thinkoco/mi-lcd/figure/clocked_video_out_timing.png

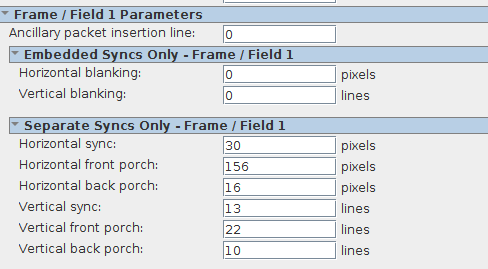
figure/clocked_video_out_timing.png
