thinkoco/mi-lcd/(list of files, drawings)

Other design files:
Schematic_PCB/Altium_Designer/5.0inch_IPS_for_TerasicDEs.PrjPCB
Schematic_PCB/Altium_Designer/5.0inch_IPS_for_TerasicDEs.SchDoc
