thinkoco/mi-lcd/Demonstration/DE10_NANO_MIL_PAINTER/software/tftlcd_ili9806g/main.c

// --------------------------------------------------------------------
// Copyright (c) 2011 by Terasic Technologies Inc. 
// --------------------------------------------------------------------
//
// Permission:
//
//   Terasic grants permission to use and modify this code for use
//   in synthesis for all Terasic Development Boards and Altera Development 
//   Kits made by Terasic.  Other use of this code, including the selling 
//   ,duplication, or modification of any portion is strictly prohibited.
//
// Disclaimer:
//
//   This VHDL/Verilog or C/C++ source code is intended as a design reference
//   which illustrates how these types of functions can be implemented.
//   It is the user's responsibility to verify their design for
//   consistency and functionality through the use of formal
//   verification methods.  Terasic provides no warranty regarding the use 
//   or functionality of this code.
//
// --------------------------------------------------------------------
//           
//                     Terasic Technologies Inc
//                     356 Fu-Shin E. Rd Sec. 1. JhuBei City,
//                     HsinChu County, Taiwan
//                     302
//
//                     web: http://www.terasic.com/
//                     email: support@terasic.com
//
// --------------------------------------------------------------------


#include "terasic_includes.h"
//#include "i2c.h"
#include "lcd.h"
#include "I2C_core.h"
#include "multi_touch2.h"
#include "gui.h"
#include "system.h"


int main()
{
	Lcd_Initialize();
    // touch
    MTC2_INFO *pTouch;
    const bool bVPG = ((IORD(KEY_BASE, 0x00) & 0x01) == 0x00)?TRUE:FALSE;
    IOWR(LED_BASE, 0x00, 0xFF); // high-active
  //  if (LCD_Open()){
   //     LCD_TextOut(bVPG?"Multi-Touch\nPattern\n" : "Multi-Touch\nPainter\n");
   // }
    printf("Terasic Painter Demo\r\n");

    oc_i2c_init(I2C_OPENCORES_0_BASE);

    usleep(1000);

    pTouch=MTC2_Init(I2C_OPENCORES_0_BASE,LCD_TOUCH_INT_BASE,LCD_TOUCH_INT_IRQ);
    if (!pTouch){
        printf("Failed to init multi-touch\r\n");
    }else{
        printf("Init touch successfully\r\n");

    }
   if (bVPG)
       GUI_VPG(pTouch); // enter vpg mode when users press KEY0
       GUI(pTouch);
  return 0;
}
