thinkoco/mi-lcd/Demonstration/DE10_NANO_MIL_PAINTER/software/nios2_mcu_bsp/system.h

/*
 * system.h - SOPC Builder system and BSP software package information
 *
 * Machine generated for CPU 'cpu' in SOPC Builder design 'MIL_PAINTER'
 * SOPC Builder design path: ../../MIL_PAINTER.sopcinfo
 *
 * Generated: Sun Oct 11 22:41:57 CST 2020
 */

/*
 * DO NOT MODIFY THIS FILE
 *
 * Changing this file will have subtle consequences
 * which will almost certainly lead to a nonfunctioning
 * system. If you do modify this file, be aware that your
 * changes will be overwritten and lost when this file
 * is generated again.
 *
 * DO NOT MODIFY THIS FILE
 */

/*
 * License Agreement
 *
 * Copyright (c) 2008
 * Altera Corporation, San Jose, California, USA.
 * All rights reserved.
 *
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
 * This agreement shall be governed in all respects by the laws of the State
 * of California and by the laws of the United States of America.
 */

#ifndef __SYSTEM_H_
#define __SYSTEM_H_

/* Include definitions from linker script generator */
#include "linker.h"


/*
 * CPU configuration
 *
 */

#define ALT_CPU_ARCHITECTURE "altera_nios2_gen2"
#define ALT_CPU_BIG_ENDIAN 0
#define ALT_CPU_BREAK_ADDR 0x05001820
#define ALT_CPU_CPU_ARCH_NIOS2_R1
#define ALT_CPU_CPU_FREQ 100000000u
#define ALT_CPU_CPU_ID_SIZE 1
#define ALT_CPU_CPU_ID_VALUE 0x00000000
#define ALT_CPU_CPU_IMPLEMENTATION "fast"
#define ALT_CPU_DATA_ADDR_WIDTH 0x1b
#define ALT_CPU_DCACHE_BYPASS_MASK 0x80000000
#define ALT_CPU_DCACHE_LINE_SIZE 32
#define ALT_CPU_DCACHE_LINE_SIZE_LOG2 5
#define ALT_CPU_DCACHE_SIZE 2048
#define ALT_CPU_EXCEPTION_ADDR 0x02000020
#define ALT_CPU_FLASH_ACCELERATOR_LINES 0
#define ALT_CPU_FLASH_ACCELERATOR_LINE_SIZE 0
#define ALT_CPU_FLUSHDA_SUPPORTED
#define ALT_CPU_FREQ 100000000
#define ALT_CPU_HARDWARE_DIVIDE_PRESENT 0
#define ALT_CPU_HARDWARE_MULTIPLY_PRESENT 1
#define ALT_CPU_HARDWARE_MULX_PRESENT 0
#define ALT_CPU_HAS_DEBUG_CORE 1
#define ALT_CPU_HAS_DEBUG_STUB
#define ALT_CPU_HAS_EXTRA_EXCEPTION_INFO
#define ALT_CPU_HAS_ILLEGAL_INSTRUCTION_EXCEPTION
#define ALT_CPU_HAS_JMPI_INSTRUCTION
#define ALT_CPU_ICACHE_LINE_SIZE 32
#define ALT_CPU_ICACHE_LINE_SIZE_LOG2 5
#define ALT_CPU_ICACHE_SIZE 4096
#define ALT_CPU_INITDA_SUPPORTED
#define ALT_CPU_INST_ADDR_WIDTH 0x1b
#define ALT_CPU_NAME "cpu"
#define ALT_CPU_NUM_OF_SHADOW_REG_SETS 0
#define ALT_CPU_OCI_VERSION 1
#define ALT_CPU_RESET_ADDR 0x02000000


/*
 * CPU configuration (with legacy prefix - don't use these anymore)
 *
 */

#define NIOS2_BIG_ENDIAN 0
#define NIOS2_BREAK_ADDR 0x05001820
#define NIOS2_CPU_ARCH_NIOS2_R1
#define NIOS2_CPU_FREQ 100000000u
#define NIOS2_CPU_ID_SIZE 1
#define NIOS2_CPU_ID_VALUE 0x00000000
#define NIOS2_CPU_IMPLEMENTATION "fast"
#define NIOS2_DATA_ADDR_WIDTH 0x1b
#define NIOS2_DCACHE_BYPASS_MASK 0x80000000
#define NIOS2_DCACHE_LINE_SIZE 32
#define NIOS2_DCACHE_LINE_SIZE_LOG2 5
#define NIOS2_DCACHE_SIZE 2048
#define NIOS2_EXCEPTION_ADDR 0x02000020
#define NIOS2_FLASH_ACCELERATOR_LINES 0
#define NIOS2_FLASH_ACCELERATOR_LINE_SIZE 0
#define NIOS2_FLUSHDA_SUPPORTED
#define NIOS2_HARDWARE_DIVIDE_PRESENT 0
#define NIOS2_HARDWARE_MULTIPLY_PRESENT 1
#define NIOS2_HARDWARE_MULX_PRESENT 0
#define NIOS2_HAS_DEBUG_CORE 1
#define NIOS2_HAS_DEBUG_STUB
#define NIOS2_HAS_EXTRA_EXCEPTION_INFO
#define NIOS2_HAS_ILLEGAL_INSTRUCTION_EXCEPTION
#define NIOS2_HAS_JMPI_INSTRUCTION
#define NIOS2_ICACHE_LINE_SIZE 32
#define NIOS2_ICACHE_LINE_SIZE_LOG2 5
#define NIOS2_ICACHE_SIZE 4096
#define NIOS2_INITDA_SUPPORTED
#define NIOS2_INST_ADDR_WIDTH 0x1b
#define NIOS2_NUM_OF_SHADOW_REG_SETS 0
#define NIOS2_OCI_VERSION 1
#define NIOS2_RESET_ADDR 0x02000000


/*
 * Define for each module class mastered by the CPU
 *
 */

#define __ALTERA_AVALON_EPCS_FLASH_CONTROLLER
#define __ALTERA_AVALON_JTAG_UART
#define __ALTERA_AVALON_PIO
#define __ALTERA_AVALON_SPI
#define __ALTERA_AVALON_SYSID_QSYS
#define __ALTERA_AVALON_TIMER
#define __ALTERA_NIOS2_GEN2
#define __ALT_VIP_VFR
#define __I2C_OPENCORES
#define __I8080_CONTROLLER
#define __MISTER_SDRAM32M_CONTROLLER


/*
 * System configuration
 *
 */

#define ALT_DEVICE_FAMILY "Cyclone V"
#define ALT_ENHANCED_INTERRUPT_API_PRESENT
#define ALT_IRQ_BASE NULL
#define ALT_LOG_PORT "/dev/null"
#define ALT_LOG_PORT_BASE 0x0
#define ALT_LOG_PORT_DEV null
#define ALT_LOG_PORT_TYPE ""
#define ALT_NUM_EXTERNAL_INTERRUPT_CONTROLLERS 0
#define ALT_NUM_INTERNAL_INTERRUPT_CONTROLLERS 1
#define ALT_NUM_INTERRUPT_CONTROLLERS 1
#define ALT_STDERR "/dev/jtag_uart"
#define ALT_STDERR_BASE 0x50020d8
#define ALT_STDERR_DEV jtag_uart
#define ALT_STDERR_IS_JTAG_UART
#define ALT_STDERR_PRESENT
#define ALT_STDERR_TYPE "altera_avalon_jtag_uart"
#define ALT_STDIN "/dev/jtag_uart"
#define ALT_STDIN_BASE 0x50020d8
#define ALT_STDIN_DEV jtag_uart
#define ALT_STDIN_IS_JTAG_UART
#define ALT_STDIN_PRESENT
#define ALT_STDIN_TYPE "altera_avalon_jtag_uart"
#define ALT_STDOUT "/dev/jtag_uart"
#define ALT_STDOUT_BASE 0x50020d8
#define ALT_STDOUT_DEV jtag_uart
#define ALT_STDOUT_IS_JTAG_UART
#define ALT_STDOUT_PRESENT
#define ALT_STDOUT_TYPE "altera_avalon_jtag_uart"
#define ALT_SYSTEM_NAME "MIL_PAINTER"


/*
 * alt_vip_vfr_0 configuration
 *
 */

#define ALT_MODULE_CLASS_alt_vip_vfr_0 alt_vip_vfr
#define ALT_VIP_VFR_0_BASE 0x5002000
#define ALT_VIP_VFR_0_IRQ 3
#define ALT_VIP_VFR_0_IRQ_INTERRUPT_CONTROLLER_ID 0
#define ALT_VIP_VFR_0_NAME "/dev/alt_vip_vfr_0"
#define ALT_VIP_VFR_0_SPAN 128
#define ALT_VIP_VFR_0_TYPE "alt_vip_vfr"


/*
 * epcs_flash_controller_0 configuration
 *
 */

#define ALT_MODULE_CLASS_epcs_flash_controller_0 altera_avalon_epcs_flash_controller
#define EPCS_FLASH_CONTROLLER_0_BASE 0x5001000
#define EPCS_FLASH_CONTROLLER_0_IRQ 4
#define EPCS_FLASH_CONTROLLER_0_IRQ_INTERRUPT_CONTROLLER_ID 0
#define EPCS_FLASH_CONTROLLER_0_NAME "/dev/epcs_flash_controller_0"
#define EPCS_FLASH_CONTROLLER_0_REGISTER_OFFSET 1024
#define EPCS_FLASH_CONTROLLER_0_SPAN 2048
#define EPCS_FLASH_CONTROLLER_0_TYPE "altera_avalon_epcs_flash_controller"


/*
 * hal configuration
 *
 */

#define ALT_INCLUDE_INSTRUCTION_RELATED_EXCEPTION_API
#define ALT_MAX_FD 32
#define ALT_SYS_CLK TIMER
#define ALT_TIMESTAMP_CLK none


/*
 * i2c_opencores_0 configuration
 *
 */

#define ALT_MODULE_CLASS_i2c_opencores_0 i2c_opencores
#define I2C_OPENCORES_0_BASE 0x50020a0
#define I2C_OPENCORES_0_IRQ 6
#define I2C_OPENCORES_0_IRQ_INTERRUPT_CONTROLLER_ID 0
#define I2C_OPENCORES_0_NAME "/dev/i2c_opencores_0"
#define I2C_OPENCORES_0_SPAN 32
#define I2C_OPENCORES_0_TYPE "i2c_opencores"


/*
 * jtag_uart configuration
 *
 */

#define ALT_MODULE_CLASS_jtag_uart altera_avalon_jtag_uart
#define JTAG_UART_BASE 0x50020d8
#define JTAG_UART_IRQ 0
#define JTAG_UART_IRQ_INTERRUPT_CONTROLLER_ID 0
#define JTAG_UART_NAME "/dev/jtag_uart"
#define JTAG_UART_READ_DEPTH 64
#define JTAG_UART_READ_THRESHOLD 8
#define JTAG_UART_SPAN 8
#define JTAG_UART_TYPE "altera_avalon_jtag_uart"
#define JTAG_UART_WRITE_DEPTH 64
#define JTAG_UART_WRITE_THRESHOLD 8


/*
 * key configuration
 *
 */

#define ALT_MODULE_CLASS_key altera_avalon_pio
#define KEY_BASE 0x4000020
#define KEY_BIT_CLEARING_EDGE_REGISTER 0
#define KEY_BIT_MODIFYING_OUTPUT_REGISTER 0
#define KEY_CAPTURE 1
#define KEY_DATA_WIDTH 4
#define KEY_DO_TEST_BENCH_WIRING 0
#define KEY_DRIVEN_SIM_VALUE 0
#define KEY_EDGE_TYPE "FALLING"
#define KEY_FREQ 20000000
#define KEY_HAS_IN 1
#define KEY_HAS_OUT 0
#define KEY_HAS_TRI 0
#define KEY_IRQ 2
#define KEY_IRQ_INTERRUPT_CONTROLLER_ID 0
#define KEY_IRQ_TYPE "EDGE"
#define KEY_NAME "/dev/key"
#define KEY_RESET_VALUE 0
#define KEY_SPAN 16
#define KEY_TYPE "altera_avalon_pio"


/*
 * lcd_i8080 configuration
 *
 */

#define ALT_MODULE_CLASS_lcd_i8080 I8080_Controller
#define LCD_I8080_BASE 0x50020d0
#define LCD_I8080_IRQ -1
#define LCD_I8080_IRQ_INTERRUPT_CONTROLLER_ID -1
#define LCD_I8080_NAME "/dev/lcd_i8080"
#define LCD_I8080_SPAN 8
#define LCD_I8080_TYPE "I8080_Controller"


/*
 * lcd_spi configuration
 *
 */

#define ALT_MODULE_CLASS_lcd_spi altera_avalon_spi
#define LCD_SPI_BASE 0x5002080
#define LCD_SPI_CLOCKMULT 1
#define LCD_SPI_CLOCKPHASE 0
#define LCD_SPI_CLOCKPOLARITY 0
#define LCD_SPI_CLOCKUNITS "Hz"
#define LCD_SPI_DATABITS 9
#define LCD_SPI_DATAWIDTH 16
#define LCD_SPI_DELAYMULT "1.0E-9"
#define LCD_SPI_DELAYUNITS "ns"
#define LCD_SPI_EXTRADELAY 0
#define LCD_SPI_INSERT_SYNC 0
#define LCD_SPI_IRQ 7
#define LCD_SPI_IRQ_INTERRUPT_CONTROLLER_ID 0
#define LCD_SPI_ISMASTER 1
#define LCD_SPI_LSBFIRST 0
#define LCD_SPI_NAME "/dev/lcd_spi"
#define LCD_SPI_NUMSLAVES 1
#define LCD_SPI_PREFIX "spi_"
#define LCD_SPI_SPAN 32
#define LCD_SPI_SYNC_REG_DEPTH 2
#define LCD_SPI_TARGETCLOCK 1000000u
#define LCD_SPI_TARGETSSDELAY "0.0"
#define LCD_SPI_TYPE "altera_avalon_spi"


/*
 * lcd_touch_int configuration
 *
 */

#define ALT_MODULE_CLASS_lcd_touch_int altera_avalon_pio
#define LCD_TOUCH_INT_BASE 0x50020c0
#define LCD_TOUCH_INT_BIT_CLEARING_EDGE_REGISTER 0
#define LCD_TOUCH_INT_BIT_MODIFYING_OUTPUT_REGISTER 0
#define LCD_TOUCH_INT_CAPTURE 1
#define LCD_TOUCH_INT_DATA_WIDTH 1
#define LCD_TOUCH_INT_DO_TEST_BENCH_WIRING 0
#define LCD_TOUCH_INT_DRIVEN_SIM_VALUE 0
#define LCD_TOUCH_INT_EDGE_TYPE "FALLING"
#define LCD_TOUCH_INT_FREQ 50000000
#define LCD_TOUCH_INT_HAS_IN 1
#define LCD_TOUCH_INT_HAS_OUT 0
#define LCD_TOUCH_INT_HAS_TRI 0
#define LCD_TOUCH_INT_IRQ 5
#define LCD_TOUCH_INT_IRQ_INTERRUPT_CONTROLLER_ID 0
#define LCD_TOUCH_INT_IRQ_TYPE "EDGE"
#define LCD_TOUCH_INT_NAME "/dev/lcd_touch_int"
#define LCD_TOUCH_INT_RESET_VALUE 0
#define LCD_TOUCH_INT_SPAN 16
#define LCD_TOUCH_INT_TYPE "altera_avalon_pio"


/*
 * led configuration
 *
 */

#define ALT_MODULE_CLASS_led altera_avalon_pio
#define LED_BASE 0x4000040
#define LED_BIT_CLEARING_EDGE_REGISTER 0
#define LED_BIT_MODIFYING_OUTPUT_REGISTER 0
#define LED_CAPTURE 0
#define LED_DATA_WIDTH 10
#define LED_DO_TEST_BENCH_WIRING 0
#define LED_DRIVEN_SIM_VALUE 0
#define LED_EDGE_TYPE "NONE"
#define LED_FREQ 20000000
#define LED_HAS_IN 0
#define LED_HAS_OUT 1
#define LED_HAS_TRI 0
#define LED_IRQ -1
#define LED_IRQ_INTERRUPT_CONTROLLER_ID -1
#define LED_IRQ_TYPE "NONE"
#define LED_NAME "/dev/led"
#define LED_RESET_VALUE 0
#define LED_SPAN 16
#define LED_TYPE "altera_avalon_pio"


/*
 * mister_sdram32m configuration
 *
 */

#define ALT_MODULE_CLASS_mister_sdram32m mister_sdram32m_controller
#define MISTER_SDRAM32M_BASE 0x2000000
#define MISTER_SDRAM32M_IRQ -1
#define MISTER_SDRAM32M_IRQ_INTERRUPT_CONTROLLER_ID -1
#define MISTER_SDRAM32M_NAME "/dev/mister_sdram32m"
#define MISTER_SDRAM32M_SPAN 33554432
#define MISTER_SDRAM32M_TYPE "mister_sdram32m_controller"


/*
 * sw configuration
 *
 */

#define ALT_MODULE_CLASS_sw altera_avalon_pio
#define SW_BASE 0x4000030
#define SW_BIT_CLEARING_EDGE_REGISTER 0
#define SW_BIT_MODIFYING_OUTPUT_REGISTER 0
#define SW_CAPTURE 0
#define SW_DATA_WIDTH 10
#define SW_DO_TEST_BENCH_WIRING 0
#define SW_DRIVEN_SIM_VALUE 0
#define SW_EDGE_TYPE "NONE"
#define SW_FREQ 20000000
#define SW_HAS_IN 1
#define SW_HAS_OUT 0
#define SW_HAS_TRI 0
#define SW_IRQ -1
#define SW_IRQ_INTERRUPT_CONTROLLER_ID -1
#define SW_IRQ_TYPE "NONE"
#define SW_NAME "/dev/sw"
#define SW_RESET_VALUE 0
#define SW_SPAN 16
#define SW_TYPE "altera_avalon_pio"


/*
 * sysid configuration
 *
 */

#define ALT_MODULE_CLASS_sysid altera_avalon_sysid_qsys
#define SYSID_BASE 0x4000050
#define SYSID_ID 0
#define SYSID_IRQ -1
#define SYSID_IRQ_INTERRUPT_CONTROLLER_ID -1
#define SYSID_NAME "/dev/sysid"
#define SYSID_SPAN 8
#define SYSID_TIMESTAMP 1602426544
#define SYSID_TYPE "altera_avalon_sysid_qsys"


/*
 * timer configuration
 *
 */

#define ALT_MODULE_CLASS_timer altera_avalon_timer
#define TIMER_ALWAYS_RUN 0
#define TIMER_BASE 0x4000000
#define TIMER_COUNTER_SIZE 32
#define TIMER_FIXED_PERIOD 0
#define TIMER_FREQ 20000000
#define TIMER_IRQ 1
#define TIMER_IRQ_INTERRUPT_CONTROLLER_ID 0
#define TIMER_LOAD_VALUE 19999
#define TIMER_MULT 0.001
#define TIMER_NAME "/dev/timer"
#define TIMER_PERIOD 1
#define TIMER_PERIOD_UNITS "ms"
#define TIMER_RESET_OUTPUT 0
#define TIMER_SNAPSHOT 1
#define TIMER_SPAN 32
#define TIMER_TICKS_PER_SEC 1000
#define TIMER_TIMEOUT_PULSE_OUTPUT 0
#define TIMER_TYPE "altera_avalon_timer"

#endif /* __SYSTEM_H_ */
