thinkoco/mi-lcd/Demonstration/DE1_SOC_MIL_PAINTER/DE1_SOC_MIL_PAINTER.v

//`define ENABLE_HPS
//`define ENABLE_USB

module DE1_SOC_MIL_PAINTER(

      ///////// ADC /////////
      inout              ADC_CS_N,
      output             ADC_DIN,
      input              ADC_DOUT,
      output             ADC_SCLK,

      ///////// AUD /////////
      input              AUD_ADCDAT,
      inout              AUD_ADCLRCK,
      inout              AUD_BCLK,
      output             AUD_DACDAT,
      inout              AUD_DACLRCK,
      output             AUD_XCK,

      ///////// CLOCK2 /////////
      input              CLOCK2_50,

      ///////// CLOCK3 /////////
      input              CLOCK3_50,

      ///////// CLOCK4 /////////
      input              CLOCK4_50,

      ///////// CLOCK /////////
      input              CLOCK_50,

      ///////// DRAM /////////
      output      [12:0] DRAM_ADDR,
      output      [1:0]  DRAM_BA,
      output             DRAM_CAS_N,
      output             DRAM_CKE,
      output             DRAM_CLK,
      output             DRAM_CS_N,
      inout       [15:0] DRAM_DQ,
      output             DRAM_LDQM,
      output             DRAM_RAS_N,
      output             DRAM_UDQM,
      output             DRAM_WE_N,

      ///////// FAN /////////
      output             FAN_CTRL,

      ///////// FPGA /////////
      output             FPGA_I2C_SCLK,
      inout              FPGA_I2C_SDAT,

      ///////// GPIO /////////
      inout     [35:0]   GPIO_0,
        
        ///////// HEX0 /////////
      output      [6:0]  HEX0,

      ///////// HEX1 /////////
      output      [6:0]  HEX1,

      ///////// HEX2 /////////
      output      [6:0]  HEX2,

      ///////// HEX3 /////////
      output      [6:0]  HEX3,

      ///////// HEX4 /////////
      output      [6:0]  HEX4,

      ///////// HEX5 /////////
      output      [6:0]  HEX5,

`ifdef ENABLE_HPS
      ///////// HPS /////////
      input              HPS_CONV_USB_N,
      output      [14:0] HPS_DDR3_ADDR,
      output      [2:0]  HPS_DDR3_BA,
      output             HPS_DDR3_CAS_N,
      output             HPS_DDR3_CKE,
      output             HPS_DDR3_CK_N,
      output             HPS_DDR3_CK_P,
      output             HPS_DDR3_CS_N,
      output      [3:0]  HPS_DDR3_DM,
      inout       [31:0] HPS_DDR3_DQ,
      inout       [3:0]  HPS_DDR3_DQS_N,
      inout       [3:0]  HPS_DDR3_DQS_P,
      output             HPS_DDR3_ODT,
      output             HPS_DDR3_RAS_N,
      output             HPS_DDR3_RESET_N,
      input              HPS_DDR3_RZQ,
      output             HPS_DDR3_WE_N,
      output             HPS_ENET_GTX_CLK,
      inout              HPS_ENET_INT_N,
      output             HPS_ENET_MDC,
      inout              HPS_ENET_MDIO,
      input              HPS_ENET_RX_CLK,
      input       [3:0]  HPS_ENET_RX_DATA,
      input              HPS_ENET_RX_DV,
      output      [3:0]  HPS_ENET_TX_DATA,
      output             HPS_ENET_TX_EN,
      inout       [3:0]  HPS_FLASH_DATA,
      output             HPS_FLASH_DCLK,
      output             HPS_FLASH_NCSO,
      inout              HPS_GSENSOR_INT,
      inout              HPS_I2C1_SCLK,
      inout              HPS_I2C1_SDAT,
      inout              HPS_I2C2_SCLK,
      inout              HPS_I2C2_SDAT,
      inout              HPS_I2C_CONTROL,
      inout              HPS_KEY,
      inout              HPS_LED,
      inout              HPS_LTC_GPIO,
      output             HPS_SD_CLK,
      inout              HPS_SD_CMD,
      inout       [3:0]  HPS_SD_DATA,
      output             HPS_SPIM_CLK,
      input              HPS_SPIM_MISO,
      output             HPS_SPIM_MOSI,
      inout              HPS_SPIM_SS,
      input              HPS_UART_RX,
      output             HPS_UART_TX,
      input              HPS_USB_CLKOUT,
      inout       [7:0]  HPS_USB_DATA,
      input              HPS_USB_DIR,
      input              HPS_USB_NXT,
      output             HPS_USB_STP,
`endif /*ENABLE_HPS*/

      ///////// IRDA /////////
      input              IRDA_RXD,
      output             IRDA_TXD,

      ///////// KEY /////////
      input       [3:0]  KEY,

      ///////// LEDR /////////
      output      [9:0]  LEDR,

      ///////// PS2 /////////
      inout              PS2_CLK,
      inout              PS2_CLK2,
      inout              PS2_DAT,
      inout              PS2_DAT2,

      ///////// SW /////////
      input       [9:0]  SW,

      ///////// TD /////////
      input              TD_CLK27,
      input      [7:0]   TD_DATA,
      input              TD_HS,
      output             TD_RESET_N,
      input              TD_VS,

`ifdef ENABLE_USB
      ///////// USB /////////
      input              USB_B2_CLK,
      inout       [7:0]  USB_B2_DATA,
      output             USB_EMPTY,
      output             USB_FULL,
      input              USB_OE_N,
      input              USB_RD_N,
      input              USB_RESET_N,
      inout              USB_SCL,
      inout              USB_SDA,
      input              USB_WR_N,
`endif /*ENABLE_USB*/

      ///////// VGA /////////
      output      [7:0]  VGA_B,
      output             VGA_BLANK_N,
      output             VGA_CLK,
      output      [7:0]  VGA_G,
      output             VGA_HS,
      output      [7:0]  VGA_R,
      output             VGA_SYNC_N,
      output             VGA_VS,

//////////// GPIO, GPIO1 connect to MIL_PAINTER - Multi-Touch LCD Panel //////////     
        input                       LCD_TE,
        inout                       LCD_SDI,
        output                  LCD_WR_SCLK,
        output                  LCD_CS,
        output                  LCD_RS_HSD,
        output                  LCD_RD_VSD,
        inout           [23:0]  LCD_DATA,
        output                  LCD_ENABLE,
        output                  LCD_PCLK,
        output                  TOUCH_SCK,
        inout                       TOUCH_SDA,
        input                       TOUCH_INT
);


//=======================================================
//  REG/WIRE declarations
//=======================================================

wire video_hs;
wire video_vs;
wire video_clk;
wire video_en;


wire [7:0]  video_r;
wire [7:0]  video_g;
wire [7:0]  video_b;
wire clk_30;
wire clk_30_out;

lcd_pll  lcd_pll_inst(
           .refclk(CLOCK2_50),   //  refclk.clk
           .rst(1'b0),      //   reset.reset
           .outclk_0(clk_30), // outclk0.clk
           .outclk_1(clk_30_out), // outclk1.clk
           .locked()    //  locked.export
);

 MIL_PAINTER u0(
        .reset_n(KEY[1]),                                  //               clk_50_clk_in_reset.reset_n
        .clk_50(CLOCK_50),                                   //                     clk_50_clk_in.clk
        .pll_sdram_clk(DRAM_CLK),                             //                         pll_sdram.clk
        
        .zs_addr_from_the_sdram(DRAM_ADDR),                   //                        sdram_wire.addr
        .zs_ba_from_the_sdram(DRAM_BA),                     //                                  .ba
        .zs_cas_n_from_the_sdram(DRAM_CAS_N),                  //                                  .cas_n
        .zs_cke_from_the_sdram(DRAM_CKE),                    //                                  .cke
        .zs_cs_n_from_the_sdram(DRAM_CS_N),                   //                                  .cs_n
        .zs_dq_to_and_from_the_sdram(DRAM_DQ),              //                                  .dq
        .zs_dqm_from_the_sdram({DRAM_UDQM,DRAM_LDQM}),                    //                                  .dqm
        .zs_ras_n_from_the_sdram(DRAM_RAS_N),                  //                                  .ras_n
        .zs_we_n_from_the_sdram(DRAM_WE_N),                   //                                  .we_n
        
        .vid_clk_to_the_alt_vip_itc_0(clk_30),             //       alt_vip_itc_0_clocked_video.vid_clk
        .vid_data_from_the_alt_vip_itc_0({video_r, video_g, video_b}),          //                                  .vid_data
        .underflow_from_the_alt_vip_itc_0(),         //                                  .underflow
        .vid_datavalid_from_the_alt_vip_itc_0(video_en),     //                                  .vid_datavalid
        .vid_v_sync_from_the_alt_vip_itc_0(video_vs),        //                                  .vid_v_sync
        .vid_h_sync_from_the_alt_vip_itc_0(video_hs),        //                                  .vid_h_sync
        .vid_f_from_the_alt_vip_itc_0(),             //                                  .vid_f
        .vid_h_from_the_alt_vip_itc_0(),             //                                  .vid_h
        .vid_v_from_the_alt_vip_itc_0(),             //                                  .vid_v
        
        .out_port_from_the_led(LEDR),                    //           led_external_connection.export
        .in_port_to_the_sw(SW),                        //            sw_external_connection.export
        .in_port_to_the_key(KEY[0]),                       //           key_external_connection.export
        
        .lcd_touch_int_external_connection_export(TOUCH_INT), // lcd_touch_int_external_connection.export
        .i2c_opencores_0_export_scl_pad_io(TOUCH_SCK),        //            i2c_opencores_0_export.scl_pad_io
        .i2c_opencores_0_export_sda_pad_io(TOUCH_SDA),         //                                  .sda_pad_io
        
        .lcd_spi_external_MOSI                    (LCD_SDI),                    //                                  .MOSI
        .lcd_spi_external_SCLK                    (LCD_WR_SCLK),                    //                                  .SCLK
        .lcd_spi_external_SS_n                    (LCD_CS)                     //    
        
    );
    
    

// vga
assign {VGA_R, VGA_G, VGA_B} = {video_r, video_g, video_b};
assign VGA_BLANK_N = 1'b1;
assign VGA_SYNC_N = 1'b0;
assign VGA_HS = ~video_hs;
assign VGA_VS = ~video_vs;
assign VGA_CLK = clk_30_out;


// MTL - display
assign LCD_DATA = {video_r, video_g, video_b};
assign LCD_PCLK = clk_30_out;
assign LCD_RS_HSD = ~video_hs;
assign LCD_RD_VSD = ~video_vs;
assign LCD_ENABLE = video_en;


endmodule
