thinkoco/mi-lcd/Demonstration/DE10_NANO_MIL_PAINTER/software/tftlcd_ili9806g/terasic_lib/I2C_core.c

// --------------------------------------------------------------------
// Copyright (c) 2007 by Terasic Technologies Inc. 
// --------------------------------------------------------------------
//
// Permission:
//
//   Terasic grants permission to use and modify this code for use
//   in synthesis for all Terasic Development Boards and Altera Development 
//   Kits made by Terasic.  Other use of this code, including the selling 
//   ,duplication, or modification of any portion is strictly prohibited.
//
// Disclaimer:
//
//   This VHDL/Verilog or C/C++ source code is intended as a design reference
//   which illustrates how these types of functions can be implemented.
//   It is the user's responsibility to verify their design for
//   consistency and functionality through the use of formal
//   verification methods.  Terasic provides no warranty regarding the use 
//   or functionality of this code.
//
// --------------------------------------------------------------------
//           
//                     Terasic Technologies Inc
//                     356 Fu-Shin E. Rd Sec. 1. JhuBei City,
//                     HsinChu County, Taiwan
//                     302
//
//                     web: http://www.terasic.com/
//                     email: support@terasic.com
//
// --------------------------------------------------------------------
#include "terasic_includes.h"
#include "I2C.h"
#include "io.h"
// Note. Remember to reset device befroe acceess I2C interface
#ifdef DEBUG_I2C
    #define I2C_DEBUG(x)    DEBUG(x)  
#else
    #define I2C_DEBUG(x)
#endif

#define SLEEP_TIME 15  //us
#define TRUE 1
#define FALSE 0

bool Write32_Data(alt_32 base_address, alt_32 offset_address, alt_32 Data){
	bool bPass;
    IOWR(base_address, offset_address,Data);
    bPass=TRUE;
    return bPass;
}



bool  Read32_Data(alt_32 base_address, alt_32 offset_address, alt_32 *pData32){
	bool bPass;
	*pData32 =IORD(base_address ,offset_address  );
	bPass=TRUE;
    return bPass;
}

bool oc_i2c_init(alt_32 i2c_base)
{
	bool bSuccess=TRUE;
	alt_32 read_data;
    // I2c sysclock =50M hz
	// i2c scl max 400k
	//scl =sysclock/(prescale*5)
   IOWR(i2c_base, 0,0x18);//write high prescale
   IOWR(i2c_base, 1,0x00);//write low prescale
   //enable the I2C core, but disable the IRQ
   IOWR( i2c_base, 2,0x80);

    read_data =IORD(i2c_base, 0);
    if( (read_data & 0x00ff) != 0x18)
    {
    	bSuccess = FALSE;
       	read_data =IORD(i2c_base, 1);
		if((read_data & 0x00ff) != 0x00){
			bSuccess = FALSE;
		}
    }
    else if (bSuccess){
    	read_data =IORD(i2c_base, 2);
        if( (read_data & 0x00ff) != 0x80 ){
            bSuccess = FALSE;
        }
    }

   if (bSuccess)
       printf("\nI2C core is enabled! \r\n");
   else
       printf("\nI2C core is not enabled! \r\n");

   return bSuccess;

}

bool  ACK_single_check(alt_32 i2c_base)
{
	bool bSuccess=TRUE;
	alt_32 read_data;

    usleep(SLEEP_TIME);
    read_data =IORD(i2c_base, 4);
    if(read_data & 0x02)
            bSuccess = FALSE;
     if (bSuccess){
            usleep(SLEEP_TIME);
            read_data =IORD(i2c_base, 4);
                if(read_data & 0x80)
                    bSuccess = FALSE;
     }
    return bSuccess;
}


bool  ACK_check(alt_32 i2c_base){
    bool bSuccess = FALSE;
    int i=0;

    while(!bSuccess && i++ < 10){
        bSuccess = ACK_single_check(i2c_base);
    }

    return bSuccess;
}

bool  OC_I2C_Write(alt_32 i2c_base,alt_u8 device_address,alt_u8 sub_address, alt_u8 *pData, int nWriteLength)
{
    //DWORD reg_data = 0x0;
    int i;
   //set the tx reg audio chip dev address with write bit
   if (!Write32_Data( i2c_base, 3,device_address)){
       printf("OC_I2C_Write error[0]\r\n");
       return FALSE;
   }
   //set STA and WR bits(bit7 and bit4)
   if (!Write32_Data( i2c_base, 4,0x90)){
       printf("OC_I2C_Write error[1]\r\n");
       return FALSE;
   }

   //wait TIP bit go to 0 to end Tx
    if(!ACK_check( i2c_base)){
        printf("OC_I2C_Write error[2]\r\n");
        return FALSE;
    }
  // printf("\n receive ACK-device address! \n");

   //set the txr reg data with reg address + 1 data MSB
   if (!Write32_Data( i2c_base, 3,sub_address)){
       printf("OC_I2C_Write error[3]\r\n");
       return FALSE;
   }

   //set WR bits(bit4)
    if (!Write32_Data( i2c_base, 4,0x10)){
        printf("OC_I2C_Write error[4]\r\n");
        return FALSE;
    }

   //wait TIP bit go to 0 to end Tx
    if(!ACK_check( i2c_base)){
        printf("OC_I2C_Write error[5]\r\n");
        return FALSE;
    }
 //  printf("\n receive ACK-reg address! \n");

#if 1
    for( i=0;i<nWriteLength;i++){
        //set the txr reg data with the data
          if (!Write32_Data( i2c_base, 3,*(pData+i))){
              printf("OC_I2C_Write error[6]\r\n");
              return FALSE;
          }

        //set STO and WR bits(bit7 and bit4)
         if (!Write32_Data( i2c_base, 4,0x10)){
             printf("OC_I2C_Write error[7]\r\n");
              return FALSE;
         }

         //wait TIP bit go to 0 to end Tx
          if(!ACK_check( i2c_base)){
              printf("OC_I2C_Write error[8]\r\n");
              return FALSE;
          }
    }

#else
  //set the txr reg data with the data
    if (!Write32_Data( i2c_base, 3,data&0xff))
        return false;

   //set STO and WR bits(bit7 and bit4)
    if (!Write32_Data( i2c_base, 4,0x10))
        return false;

   //wait TIP bit go to 0 to end Tx
    if(!ACK_check( i2c_base))
        return false;
#endif

     if (!Write32_Data( i2c_base, 4,0x40)){
         printf("OC_I2C_Write error[9]\r\n");
         return FALSE;
     }
         //Sleep(10);
     //OS_msleep(1);
     usleep(SLEEP_TIME);

  // printf("\n receive ACK-data! \n");

     return TRUE;

}


bool ACK_judge_for_read(alt_32 i2c_base)
{
	bool bSuccess;
    alt_32 this_data;

   // OS_msleep( SLEEP_TIME );
     usleep(SLEEP_TIME);
    //   while(this_data & 0x02)
//   {
//      this_data =  Read32_Data ( hPCIe, i2c_base, 4);
//   }
    bSuccess =  Read32_Data ( i2c_base, 4, &this_data);
    if (bSuccess){
        if(this_data & 0x02)
            bSuccess = FALSE;
    }
   //wait the rx ACK signal 0-valid

    return bSuccess;

}


bool  OC_I2C_Read(alt_32 i2c_base,alt_u8 device_address,alt_u8 sub_address, alt_u8 *pData8, int nReadLength){

    //DWORD reg_data = 0x0;
    //BYTE data = 0x0;
    alt_32 Data32;
    int i;

   //set the tx reg audio chip dev address with write bit
   IOWR( i2c_base, 3,device_address);
   //set STA and WR bits(bit7 and bit4)
   IOWR( i2c_base, 4,0x90);
   //wait TIP bit go to 0 to end Tx
   if (!ACK_check( i2c_base)){
       printf("OC_I2C_Read error[2]\r\n");
       return FALSE;
   }
   IOWR(i2c_base, 3,sub_address);

   //set WR bits(bit4)
   IOWR( i2c_base, 4,0x10);
   //wait TIP bit go to 0 to end Tx
    if (!ACK_check( i2c_base)){
        printf("OC_I2C_Read error[5]\r\n");
        return FALSE;
    }
  // printf("\n read receive ACK-reg address! \n");

   //read
    //set the tx reg audio chip dev address with read bit 1
    IOWR(i2c_base, 3,device_address|0x01);

   //set STA and WR bits(bit7 and bit4)
    IOWR( i2c_base, 4,0x90);

   //wait TIP bit go to 0 to end Tx
    if (!ACK_check( i2c_base)){
        printf("OC_I2C_Read error[8]\r\n");
        return FALSE;
    }

    for(i=0;i<nReadLength;i++){
  // printf("\n read receive ACK-device address(read)! \n");
   //set the RD and ACK bit(bit5 and bit3)
    	IOWR( i2c_base, 4,((i+1) == nReadLength)?0x28:0x20);

        if (!ACK_judge_for_read( i2c_base)){
            printf("OC_I2C_Read error[10]\r\n");
            return FALSE;
        }
   // printf("\n read receive ACK-device address(read)! \n");

        Data32=IORD( i2c_base, 3);
        *(pData8+i) =  Data32 & 0xff;
    }

    IOWR( i2c_base, 4,0x40);

  // Sleep(10);
   //OS_msleep(1);
    usleep(SLEEP_TIME);
 //  printf(" Read  [%02X] = %02Xh\r\n", sub_address, data);


   return TRUE;

}
//  size > 2Kb
bool  OC_I2CL_Write(alt_32 i2c_base,alt_u8 device_address,int sub_address,alt_u8 *pData, int nWriteLength)
    {
    //DWORD reg_data = 0x0;
	alt_u8 AddrHigh, AddrLow;
    //int count= 0;

    AddrHigh = (sub_address >> 8) & 0xFF;
    AddrLow  = sub_address & 0xFF;

    int i;

    //set the tx reg audio chip dev address with write bit
   if (!Write32_Data( i2c_base, 3,device_address))
       return FALSE;
   //set STA and WR bits(bit7 and bit4)
   if (!Write32_Data( i2c_base, 4,0x90))//0x90
       return FALSE;

   //wait TIP bit go to 0 to end Tx
    if(!ACK_check( i2c_base))
        return FALSE;
  // printf("\n receive ACK-device address! \n");

   //set the txr reg data with reg address + 1 data MSB
 //  reg_data  = (sub_address << 1) & 0xFE;
   //reg_data |= ((data >> 8) & 0x01);
   if (!Write32_Data( i2c_base, 3,AddrHigh))//reg_data&0xff);
       return FALSE;

   //set WR bits(bit4)
    if (!Write32_Data( i2c_base, 4,0x10))
        return FALSE;

   //wait TIP bit go to 0 to end Tx
    if(!ACK_check( i2c_base))
        return FALSE;
  // printf("\n receive ACK-reg high address! \n");

   //set the txr reg data with reg address + 1 data MSB
   if (!Write32_Data( i2c_base, 3,AddrLow))//reg_data&0xff);
       return FALSE;

   //set WR bits(bit4)
    Write32_Data( i2c_base, 4,0x10);

   //wait TIP bit go to 0 to end Tx
    if(!ACK_check( i2c_base))
        return FALSE;
  //  printf("\n receive ACK-reg low address! \n");

#if 1
    for( i=0;i<nWriteLength;i++){
        //set the txr reg data with the other data 8 bit LSB
        if (!Write32_Data( i2c_base, 3,*(pData+i)))
            return FALSE;

       //set STO and WR bits(bit7 and bit4)
        if (!Write32_Data( i2c_base, 4,0x10))
            return FALSE;

        //wait TIP bit go to 0 to end Tx
         if(!ACK_check( i2c_base))
             return FALSE;
    }
#else
    //set the txr reg data with the other data 8 bit LSB
    if (!Write32_Data( i2c_base, 3,data&0xff))
        return false;

   //set STO and WR bits(bit7 and bit4)
    if (!Write32_Data( i2c_base, 4,0x10))
        return FALSE;

   //wait TIP bit go to 0 to end Tx
    if(!ACK_check( i2c_base))
        return FALSE;

#endif
    if (!Write32_Data( i2c_base, 4,0x40))
         return FALSE;

     //OS_msleep(1);
      usleep(SLEEP_TIME);
  //  printf("\n receive ACK-data! \n");

     return TRUE;
}


bool  OC_I2CL_Read(alt_32 i2c_base,alt_u8 device_address,int sub_address, alt_u8 *pData8){

    //DWORD reg_data = 0x0;
    alt_32 Data32;// = 0x0;

    alt_u8 AddrHigh, AddrLow;

    AddrHigh = (sub_address >> 8) & 0xFF;
    AddrLow  = sub_address & 0xFF;


   //set the tx reg audio chip dev address with write bit
   if (!Write32_Data( i2c_base, 3,device_address))
       return FALSE;
   //set STA and WR bits(bit7 and bit4)
   if (!Write32_Data( i2c_base, 4,0x90))
       return FALSE;

   //wait TIP bit go to 0 to end Tx
    if(!ACK_check( i2c_base))
        return FALSE;
 //  printf("\n receive ACK-device address! \n");


   //set the txr reg data with reg address + 0

   if (!Write32_Data( i2c_base, 3,AddrHigh))//reg_data&0xff);
       return FALSE;

   //set WR bits(bit4)
    if (!Write32_Data( i2c_base, 4,0x10))
        return FALSE;

   //wait TIP bit go to 0 to end Tx
    if(!ACK_check( i2c_base))
        return FALSE;
//   printf("\n read receive ACK-reg High address! \n");

     //set the txr reg data with reg address + 0
   if (!Write32_Data( i2c_base, 3,AddrLow)) //;//reg_data&0xff);
       return FALSE;

   //set WR bits(bit4)
    if (!Write32_Data( i2c_base, 4,0x10))
        return FALSE;

   //wait TIP bit go to 0 to end Tx
    if(!ACK_check( i2c_base))
        return FALSE;

 //  printf("\n read receive ACK-reg Low address! \n");

   //read
    //set the tx reg audio chip dev address with read bit 1
     if (!Write32_Data( i2c_base, 3,device_address|0x01))
         return FALSE;

   //set STA and WR bits(bit7 and bit4)
     if (!Write32_Data( i2c_base, 4,0x90))
         return FALSE;

   //wait TIP bit go to 0 to end Tx
    if(!ACK_check( i2c_base))
        return FALSE;
//   printf("\n read receive ACK-device address(read)! \n");

       //read the rxr data


   //set the RD and ACK bit(bit5 and bit3)
    if (!Write32_Data( i2c_base, 4,0x28))
        return FALSE;

   //wait TIP bit go to 0 to end Tx
    if(!ACK_judge_for_read( i2c_base))
        return FALSE;

//    printf("\n read receive ACK-device address(read)! \n");
    if (!Read32_Data ( i2c_base, 3, &Data32))
        return FALSE;

    *pData8 =  Data32 & 0xff;


   if (!Write32_Data( i2c_base, 4,0x40))
       return FALSE;

   //OS_msleep(1);
    usleep(SLEEP_TIME);

   return TRUE;

}
