thinkoco/mi-lcd/Demonstration/DE10_NANO_MIL_PAINTER/software/tftlcd_ili9806g/lcd.h

#ifndef __LCD_H
#define __LCD_H
typedef  unsigned char u8;
typedef unsigned short u16;
typedef unsigned int u32;

//Lcd初始化及其低级控制函数
void Lcd_Initialize(void);
void Lcd_WR_Start(void);
//Lcd高级控制函数
void Lcd_ColorBox(u16 x,u16 y,u16 xLong,u16 yLong,u16 Color);
void DrawPixel(u16 x, u16 y, u16 Color);
u16 ReadPixel(u16 x,u8 y);
void LCD_Fill_Pic(u16 x, u16 y,u16 pic_H, u16 pic_V, const unsigned char* pic);
void BlockWrite(unsigned int Xstart,unsigned int Xend,unsigned int Ystart,unsigned int Yend);


void delay_ms (u32 tm);

/*定义常见颜色*/
// #define red 0x001f
// #define blue 0xf800
// #define green 0x07e0
// #define black 0x0000
// #define white 0xffff
// #define yellow 0x07ff
// #define orange 0x05bf
// #define Chocolate4 0x4451
// #define Grey 0xefbd//灰色

#define White          0xFFFF
#define Black          0x0000
#define Blue           0x001F
#define Blue2          0x051F
#define Red            0xF800
#define Magenta        0xF81F
#define Green          0x07E0
#define Cyan           0x7FFF
#define Yellow         0xFFE0


#endif  
	 
	 
