thinkoco/mi-lcd/(commit log)

2019-01-09 add DE10_Nano linux framebuffer hardware
2019-01-11 add PLL clock to fix LCD PCLK
    [lcd_pll.v, lcd_pll_0002.v]
2019-01-12 add schematic and PCB layout
    [5.0inch_IPS_for_TerasicDEs.SchDoc]
2019-04-28 fixed Horizontal and Vertical back porch in initialization code
    [lcd_spi_init.v]
2019-05-04 add tinydrm and touch sreen driver
2019-05-04 add DE1-SoC printer demo
2019-08-14 add pcb project file
    [5.0inch_IPS_for_TerasicDEs.PrjPCB]
2020-10-18 fixed hsync vsync high active
    [DE10_NANO_MIL_PAINTER.v, lcd.c]
